bugg-resources/bugg-hardware-mic/README.md

# bugg-hardware-mic

This repository contains the KiCad source files for the microphone PCB of the Bugg recording device.

For a full overview of the design of the Bugg recording device and practical assembly instructions please refer to the [Bugg hardware handover document](https://raw.githubusercontent.com/bugg-resources/bugg-handover/master/bugg-handover.pdf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).

## Electronics overview

Bugg full assembly - side

## BoM

[Interactive BoM for the microphone board](https://raw.githack.com/jeffmakes/bugg-hardware-mic/main/r4/build/bugg-mic-r4-bom/bugg-mic-r4.html)
