bugg-resources/bugg-hardware-mic/r3/build/safeproject-mic-r3.pdf

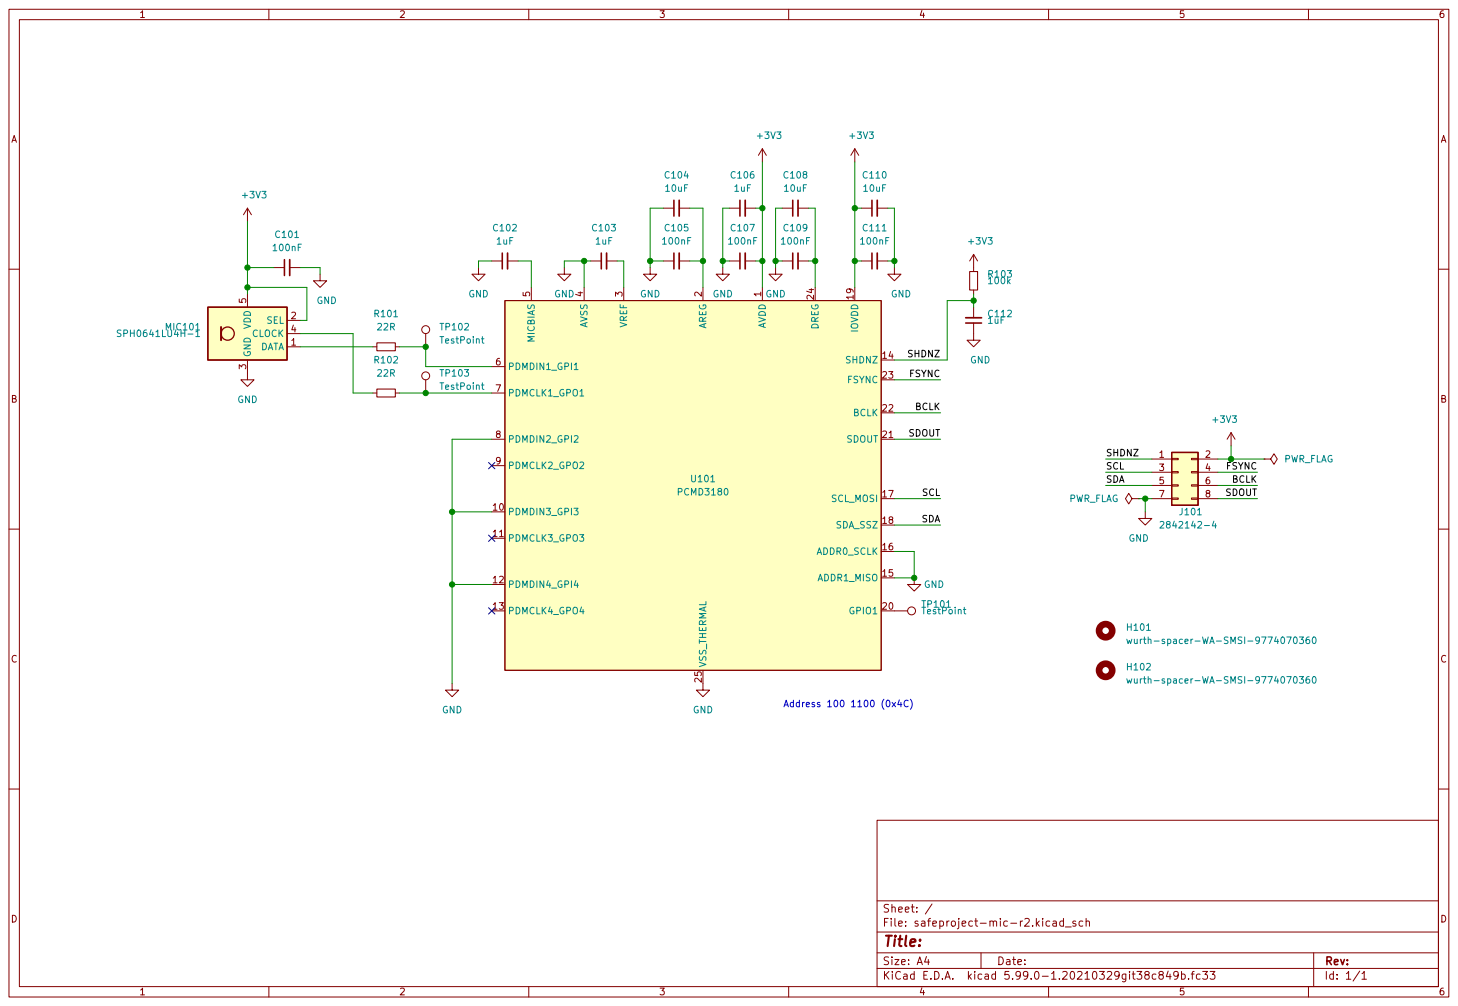
[picture p1: page 1]

2 GPIO1 20 SDOUT 21 BCLK 22 FSYNC 23 DREG 24 VSS_THERMAL 25 VREF

SHDNZ SCL SDOUT BCLK
FSYNC

H101wurth-spacer-WA-SMSI-9774070360 H102wurth-spacer-WA-SMSI-9774070360 ~

File: safeproject-mic-r2.kicad_sch Sheet: /
Id: 1/1 Title:
