bugg-resources/bugg-hardware-mic/r5/build/bugg-mic-r5-fabrication/bugg-mic-r5-Edge_Cuts.pdf

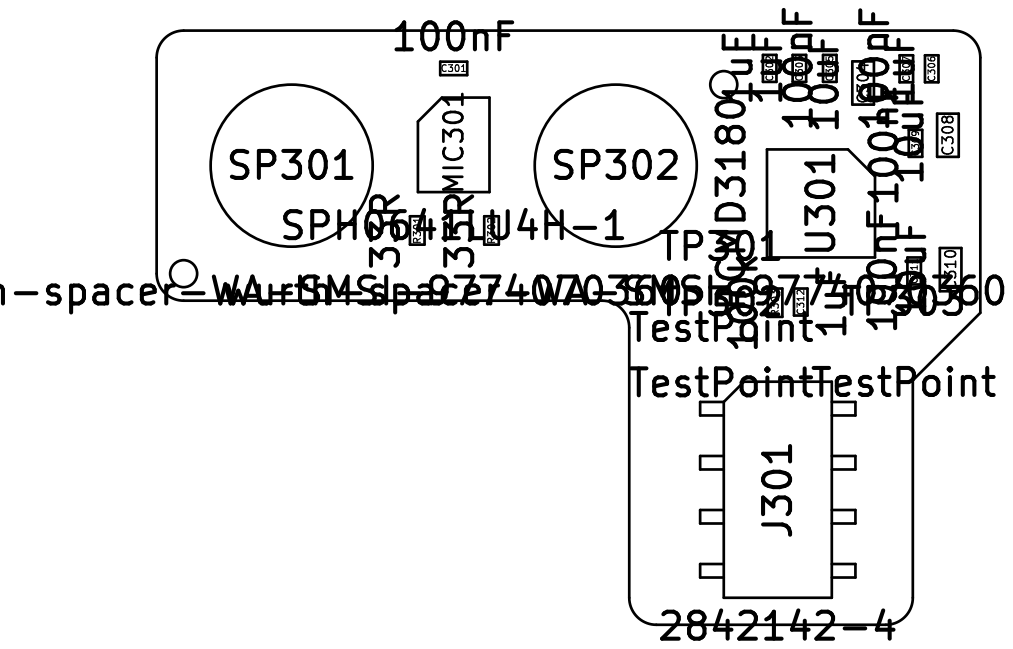
[picture p2: page 1]

1uFC303 100nF C309 TestPoint TP303 10uF C304 100nF C311 TestPoint TP302 10uF C310 1uFC312 100nF C307 wurth-spacer-WA-SMSI-9774070360 SP302 33RR302 2842142-4J301 33RR301 PCMD3180 U301 wurth-spacer-WA-SMSI-9774070360 SP301 1uFC306 1uFC302 SPH0641LU4H-1 MIC301 100k R303 TestPoint TP301 10uF C308100nF C305 100nF C301
