bugg-resources/bugg-hardware-mic/r5/build/bugg-mic-r5-assembly/bugg-mic-r5-F_Fab.pdf

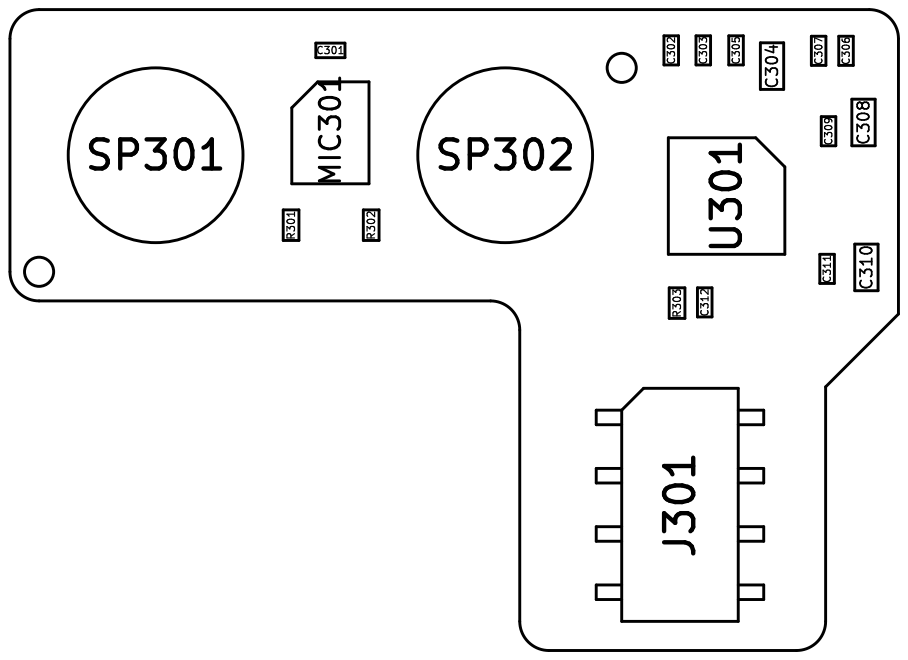
[picture p3: page 1]
