bugg-resources/bugg-hardware-mic/(commit log)

2021-01-23 Add project structure, add mic to schematic.
    [safeproject-mic-r1.kicad_pcb, safeproject-mic-r1.kicad_sch]
2021-01-23 Mic and PCMD3180
    [safeproject-mic-r1.kicad_sch]
2021-01-24 Schematic complete, ERC pass, footprints assigned
    [safeproject-mic-r1.kicad_pcb, safeproject-mic-r1.kicad_sch]
2021-01-24 Parts placed, board outline defined
    [safeproject-mic-r1.kicad_pcb, safeproject-mic-r1.kicad_sch]
2021-01-24 Routing complete
    [safeproject-mic-r1.kicad_pcb, safeproject-mic-r1.kicad_sch]
2021-01-24 Update footprints to include corrected spacer paste patterns
    [safeproject-mic-r1.kicad_pcb]
2021-01-24 Add test points for PDM signals
    [safeproject-mic-r1.kicad_pcb, safeproject-mic-r1.kicad_sch]
2021-01-24 Remove silkscreen from most parts, add it for testpoints and board name
    [safeproject-mic-r1.kicad_pcb]
2021-01-24 DRC pass :D
    [safeproject-mic-r1.kicad_pcb]
2021-01-24 Replace incorrect pin socket with correct pin header, mirror connections to avoid re-routing. DRC passed
    [safeproject-mic-r1.kicad_pcb, safeproject-mic-r1.kicad_sch]
2021-01-25 Bring in board edge by connector to better clear the inner pitch angle of the enclosure roof
    [safeproject-mic-r1.kicad_pcb]
2021-01-25 DRC pass
    [safeproject-mic-r1.kicad_pcb]
2021-03-07 Change kicad library remotes to track the new Gitlab version, which migrates symbols to Kicad 5 format and is the new location for all libraries
2021-05-20 Update project to new Kicad format
    [safeproject-mic-r1.kicad_pcb, safeproject-mic-r1.kicad_sch, safeproject-mic-r1_bom_.csv]
2021-05-20 r1 bom
    [bom-r1.xlsx]
2021-05-20 Import r2
    [bom-r1.xlsx, safeproject-mic-r2.kicad_pcb, safeproject-mic-r2.kicad_sch]
2021-05-20 PDF schematic
2021-05-20 Old BOM
    [bom-r1.xlsx]
2021-05-20 Add fiducials. Change text, move to mask layer.
    [safeproject-mic-r3.kicad_pcb, safeproject-mic-r3.kicad_sch]
2021-05-23 Update footprint table to include updated Kicad lib
2021-05-23 Connect Wurth spacer mounting pads to GND
    [safeproject-mic-r3.kicad_pcb, safeproject-mic-r3.kicad_sch]
2021-05-23 Shorten test point names
    [safeproject-mic-r3.kicad_pcb, safeproject-mic-r3.kicad_sch]
2021-05-23 Move fiducial and GND via out of the way of the mousebite area
    [safeproject-mic-r3.kicad_pcb]
2022-11-24 Update URL's for Kicad libs
2022-11-24 Create new folder structure for r4
    [bugg-mic-r4.kicad_pcb, bugg-mic-r4.kicad_sch]
2022-11-24 Update files to Kicad 6 format
    [bugg-mic-r4.kicad_pcb, bugg-mic-r4.kicad_sch]
2022-11-24 ERC pass
    [bugg-mic-r4.kicad_sch]
2022-11-24 Remove missing footprint library references
2022-11-24 Update Wurth spacers to remove DRC violations. DRC pass
    [bugg-mic-r4.kicad_pcb, bugg-mic-r4.kicad_sch]
2022-11-24 Custom DRC rules for Wurth spacers
2022-11-24 Silkscreen done. DRC pass
    [bugg-mic-r4.kicad_pcb]
2022-11-24 BoM updated
    [bugg-mic-r4.csv, bugg-mic-r4.xlsx]
2022-11-25 gitignore bom xml
2022-11-25 Add some cap voltages and other bom-related parameters
    [bugg-mic-r4.kicad_pcb, bugg-mic-r4.kicad_sch]
2022-11-28 Fix central core thickness. DRC pass
    [bugg-mic-r4.kicad_pcb]
2022-11-28 BoM update, add iBOM
    [bugg-mic-r4.csv]
2022-11-28 Fabrication outputs
    [bugg-mic-r4-B_Cu.gbr, bugg-mic-r4-B_Mask.gbr, bugg-mic-r4-B_Paste.gbr, bugg-mic-r4-B_Silkscreen.gbr, bugg-mic-r4-Edge_Cuts.gbr, bugg-mic-r4-F_Cu.gbr, bugg-mic-r4-F_Mask.gbr, bugg-mic-r4-F_Paste.gbr]
2023-10-01 Create project tree for mic board r5 based on r4
    [bugg-mic-r5.kicad_pcb, bugg-mic-r5.kicad_sch]
2023-10-01 Update submodules to match remote heads (i.e. fetch the latest official Kicad repos, as well as my own lib
2023-10-01 Update files to Kicad 7 format
    [bugg-mic-r5.kicad_pcb, bugg-mic-r5.kicad_sch]
2023-10-01 Replace 0603 resistor with 0402
    [bugg-mic-r5.kicad_pcb, bugg-mic-r5.kicad_sch]
2023-10-01 Replace board-to-board header with type with alignment pegs
    [bugg-mic-r5.kicad_sch]
2023-10-01 Re-route with new board-to-board connector with alignment pegs
    [bugg-mic-r5.kicad_pcb]
2023-10-03 Fabrication and assembly data
    [bugg-mic-r5-B_Cu.gbr, bugg-mic-r5-B_Mask.gbr, bugg-mic-r5-B_Paste.gbr, bugg-mic-r5-B_Silkscreen.gbr, bugg-mic-r5-Edge_Cuts.gbr, bugg-mic-r5-F_Cu.gbr, bugg-mic-r5-F_Mask.gbr, bugg-mic-r5-F_Paste.gbr]
2023-10-10 Fabrication data exported with lacKi
    [bugg-mic-r5-B_Cu.gbl, bugg-mic-r5-B_Mask.gbs, bugg-mic-r5-B_Paste.gbp, bugg-mic-r5-B_Silkscreen.gbo, bugg-mic-r5-Edge_Cuts.gm1, bugg-mic-r5-F_Cu.gtl, bugg-mic-r5-F_Mask.gts, bugg-mic-r5-F_Paste.gtp]
2023-12-13 Updated gerbers
    [bugg-mic-r5-B_Cu.gbl, bugg-mic-r5-B_Mask.gbs, bugg-mic-r5-B_Paste.gbp, bugg-mic-r5-B_Silkscreen.gbo, bugg-mic-r5-Edge_Cuts.gm1, bugg-mic-r5-F_Cu.gtl, bugg-mic-r5-F_Mask.gts, bugg-mic-r5-F_Paste.gtp]
2023-12-13 Update to new Kicad nightly - file format update, add plot origin
    [bugg-mic-r5.kicad_pcb]
2023-12-13 Interactive HTML BOM
2023-12-13 Assembly data, reference plot
