bugg-resources/bugg-hardware-mic/(notices)

Notices in the files:
README.md:
cc-by-nc-sa-shield
